Residuum22/EDFAController/README.md

# EDFAController
This project was created for my MSc thesis This project mixes the mm_edfa_boards and mm_edfa_web projects.
