Residuum22/EDFAController/EDFABoards/Simulation/ESDProtection/ESDProtection.asc

A1: varistor
C1: cap; 100n
D1: TVSdiode; SMCJ33A
L1: ind; 220m
R1: res; 100
V1: voltage; PULSE(0 500 1 20m 20m 1 3)
V2: voltage; 30
Named nets: 0
.tran 5
