Residuum22/EDFAController/EDFABoards/Simulation/LaserControllerCircuit/LaserControllerCircuit.asc

D1: LED; LXHL-BW02
D2: LED; LXHL-BW02
M1: nmos; RTL035N03
M3: nmos; RTL035N03
R1: res; 100
R2: res; 10k
R3: res; 0.1
R4: res; 680
R5: res; 0.42
R6: res; 100
R7: res; 0.1
R8: res; 10k
R9: res; 300
R10: res; 0.076
R11: res; 10k
R13: res; 10k
U1: OP07
U2: OP07
V2: voltage; 5
V5: voltage; PWL file=C:\Users\mihal\development\PWLGenerator\demofile2.txt
Named nets: 5V, 0, SIGNAL
.tran 30
980 nm Pump Laser
1480 nm Pump Laser
