Residuum22/EDFAController/EDFABoards/Simulation/MonitorDiode/monitordiode.asc

C1: cap; 10µ
D1: diode
I1: current; SINE(200e-6 200e-6 1)
R1: res; 10k
R2: res; 10k
R3: res; 10k
U1: OP07
V1: voltage; 5
Named nets: 0, 5V
.tran 1
