Residuum22/EDFAController/EDFABoards/Simulation/ReserveAndOverVoltageProtection/ReserveOverVoltageProtection.asc

D1: zener; UMZ5_1N
D2: zener; MMBZ6V8ALY
M1: pmos; Si7137DP
M2: pmos; Si7137DP
M3: pmos; Si7137DP
R1: res; 10k
R2: res; 10k
R3: res; 10k
R4: res; 100
V1: voltage; PWL(0 0 1 5 2 5 3 6 4 6 5 0 6 0 7 -5 8 -5)
Named nets: 0
.tran 8s
