Residuum22/EDFAController/EDFABoards/Hardware/cable_board_kicad_prj/cable_board_kicad_prj.kicad_pcb

## KiCad design EDFABoards/Hardware/cable_board_kicad_prj/cable_board_kicad_prj.kicad_pcb (2024-10-13)

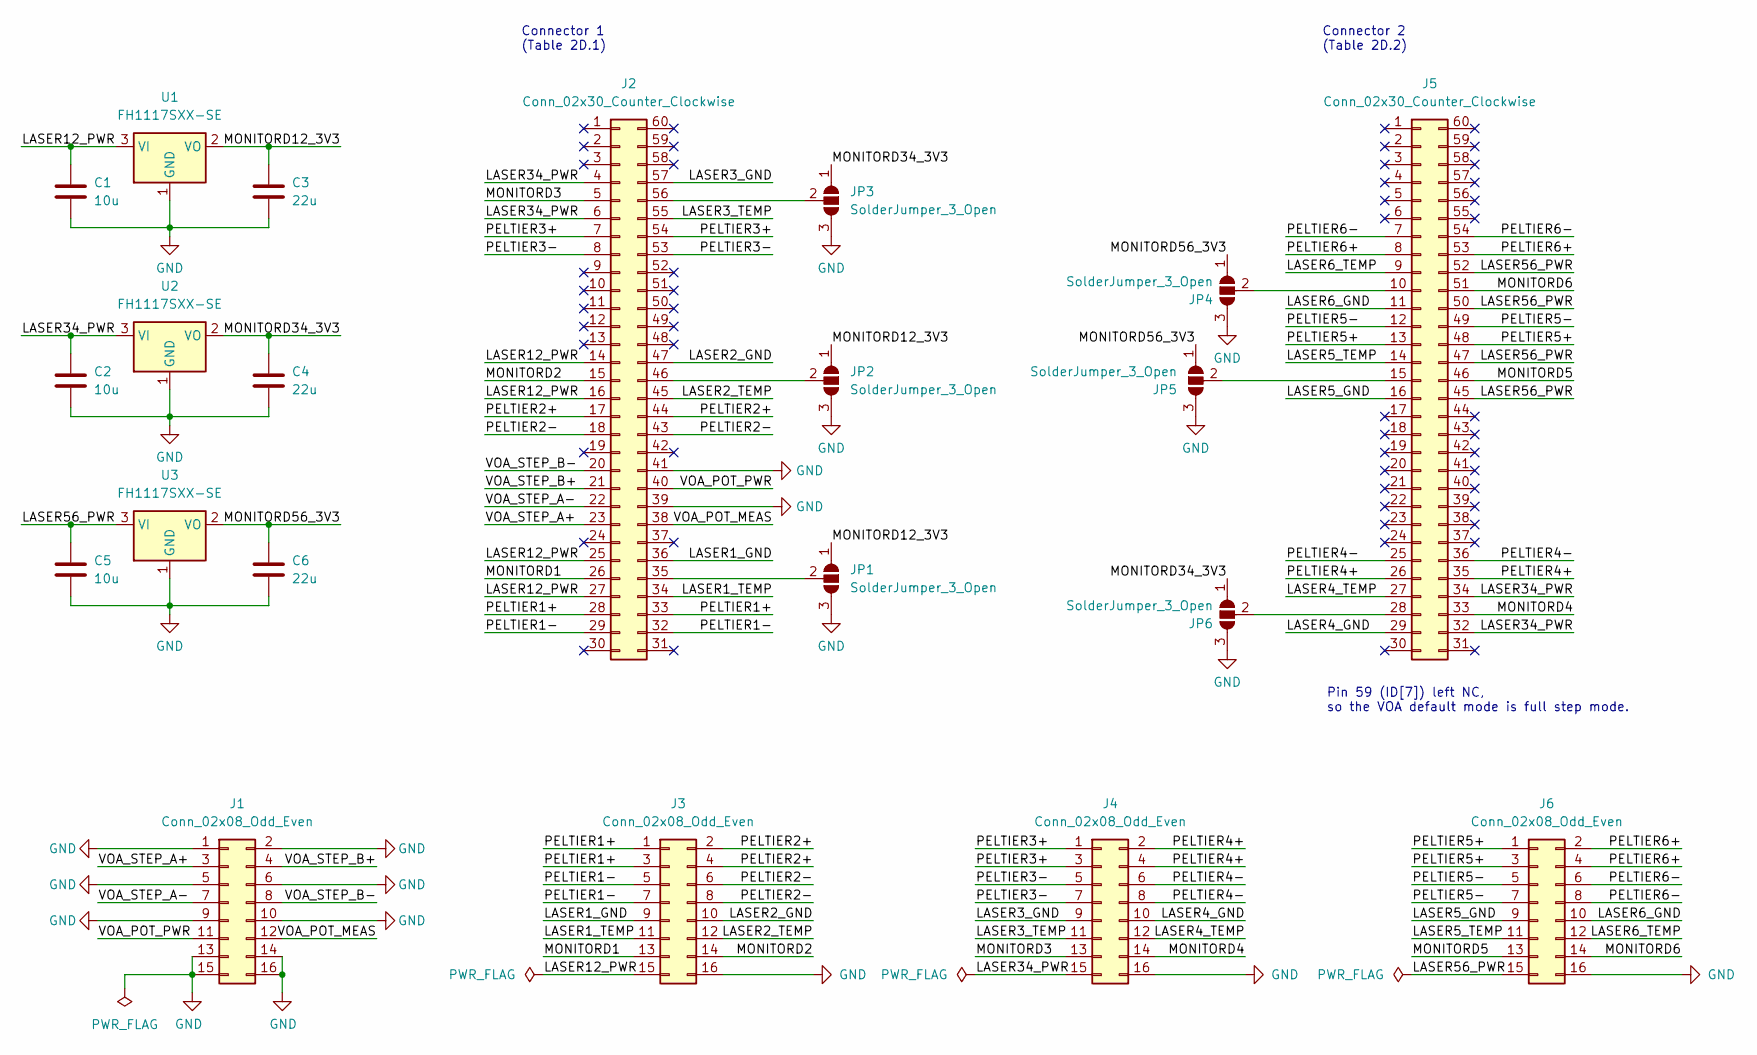
[picture p2: schematic cable_board_kicad_prj.kicad_sch, Cable board]

Parts:
C1, C2, C5: 10u; C_0805_2012Metric_Pad1.18x1.45mm_HandSolder
C3, C4, C6: 22u; C_0805_2012Metric_Pad1.18x1.45mm_HandSolder
J1, J3, J4, J6: Conn_02x08_Odd_Even; IDC-Header_2x08_P2.54mm_Latch_Vertical
J2, J5: Conn_02x30_Counter_Clockwise; IDC-Header_2x30_P2.54mm_Latch_Vertical
JP1, JP2, JP3, JP4, JP5, JP6: SolderJumper_3_Open; SolderJumper-3_P1.3mm_Open_RoundedPad1.0x1.5mm
U1, U2, U3: FH1117SXX-SE; SOT-223-3_TabPin2

Connections:
/LASER1_GND: J2.36, J3.9
/LASER1_TEMP: J2.34, J3.11
/LASER2_GND: J2.47, J3.10
/LASER2_TEMP: J2.45, J3.12
/LASER3_GND: J2.57, J4.9
/LASER3_TEMP: J2.55, J4.11
/LASER4_GND: J4.10, J5.29
/LASER4_TEMP: J4.12, J5.27
/LASER5_GND: J5.16, J6.9
/LASER5_TEMP: J5.14, J6.11
/LASER6_GND: J5.11, J6.10
/LASER6_TEMP: J5.9, J6.12
/LASER12_PWR: C1.1, J2.14, J2.16, J2.25, J2.27, J3.15, U1.3 (VI)
/LASER34_PWR: C2.1, J2.4, J2.6, J4.15, J5.32, J5.34, U2.3 (VI)
/LASER56_PWR: C5.1, J5.45, J5.47, J5.50, J5.52, J6.15, U3.3 (VI)
/MONITORD1: J2.26, J3.13
/MONITORD2: J2.15, J3.14
/MONITORD3: J2.5, J4.13
/MONITORD4: J4.14, J5.33
/MONITORD5: J5.46, J6.13
/MONITORD6: J5.51, J6.14
/MONITORD12_3V3: C3.1, JP1.1 (A), JP2.1 (A), U1.2 (VO)
/MONITORD34_3V3: C4.1, JP3.1 (A), JP6.1 (A), U2.2 (VO)
/MONITORD56_3V3: C6.1, JP4.1 (A), JP5.1 (A), U3.2 (VO)
/PELTIER1+: J2.28, J2.33, J3.1, J3.3
/PELTIER1-: J2.29, J2.32, J3.5, J3.7
/PELTIER2+: J2.17, J2.44, J3.2, J3.4
/PELTIER2-: J2.18, J2.43, J3.6, J3.8
/PELTIER3+: J2.7, J2.54, J4.1, J4.3
/PELTIER3-: J2.8, J2.53, J4.5, J4.7
/PELTIER4+: J4.2, J4.4, J5.26, J5.35
/PELTIER4-: J4.6, J4.8, J5.25, J5.36
/PELTIER5+: J5.13, J5.48, J6.1, J6.3
/PELTIER5-: J5.12, J5.49, J6.5, J6.7
/PELTIER6+: J5.8, J5.53, J6.2, J6.4
/PELTIER6-: J5.7, J5.54, J6.6, J6.8
/VOA_POT_MEAS: J1.12, J2.38
/VOA_POT_PWR: J1.11, J2.40
/VOA_STEP_A+: J1.3, J2.23
/VOA_STEP_A-: J1.7, J2.22
/VOA_STEP_B+: J1.4, J2.21
/VOA_STEP_B-: J1.8, J2.20
GND: C1.2, C2.2, C3.2, C4.2, C5.2, C6.2, J1.1, J1.2, J1.5, J1.6, J1.9, J1.10, J1.13, J1.14, J1.15, J1.16, J2.39, J2.41, J3.16, J4.16, J6.16, JP1.3 (B), JP2.3 (B), JP3.3 (B), JP4.3 (B), JP5.3 (B), JP6.3 (B), U1.1 (GND), U2.1 (GND), U3.1 (GND)
unnamed: J2.35, JP1.2 (C)
unnamed: J2.46, JP2.2 (C)
unnamed: J2.56, JP3.2 (C)
unnamed: J5.10, JP4.2 (C)
unnamed: J5.15, JP5.2 (C)
unnamed: J5.28, JP6.2 (C)

Notes on the sheet:
Connector 1 (Table 2D.1)
Connector 2 (Table 2D.2)
Pin 59 (ID[7]) left NC, so the VOA default mode is full step mode.

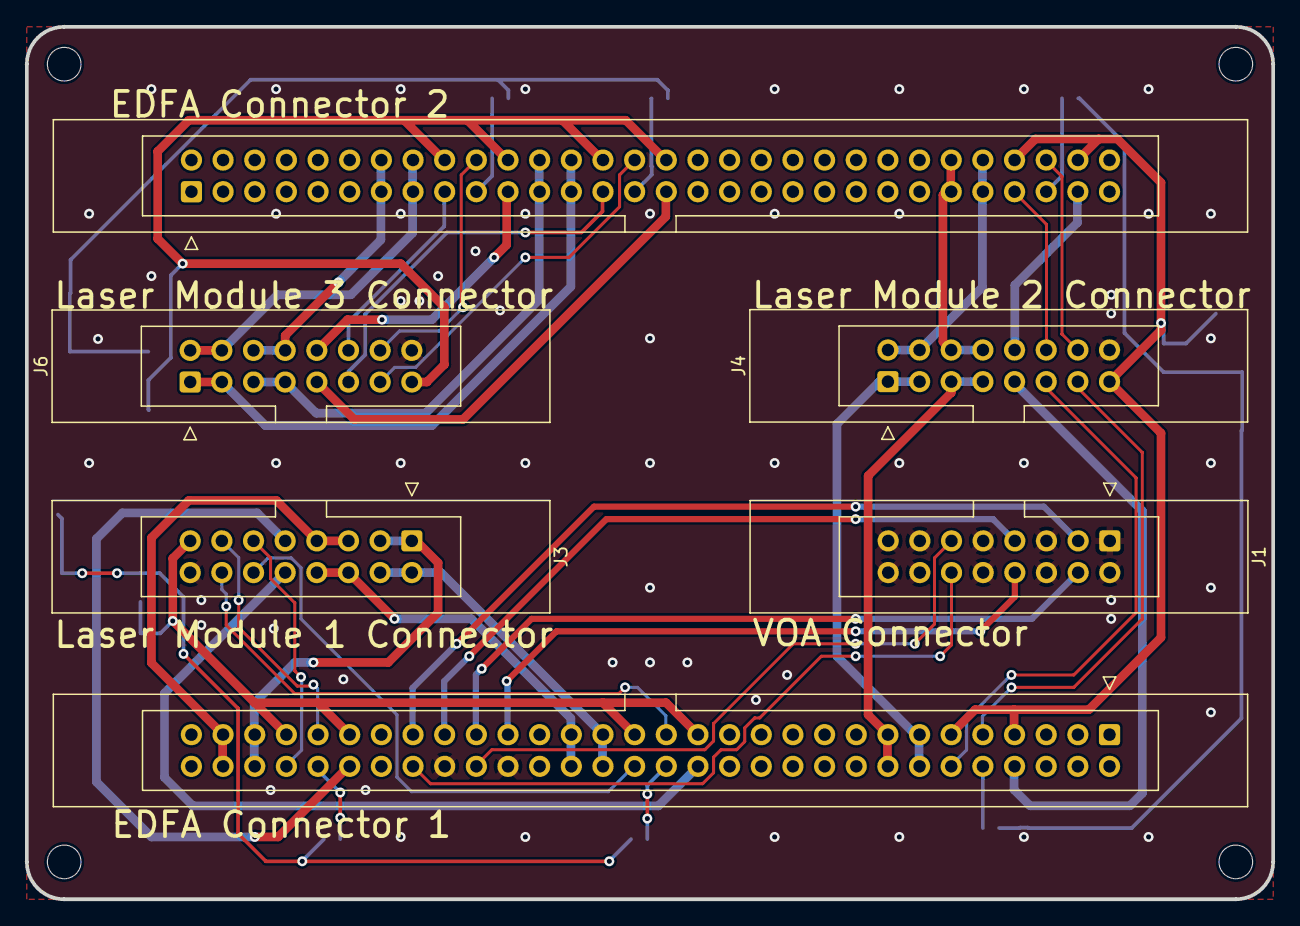
[picture p3: board cable_board_kicad_prj.kicad_pcb from above]

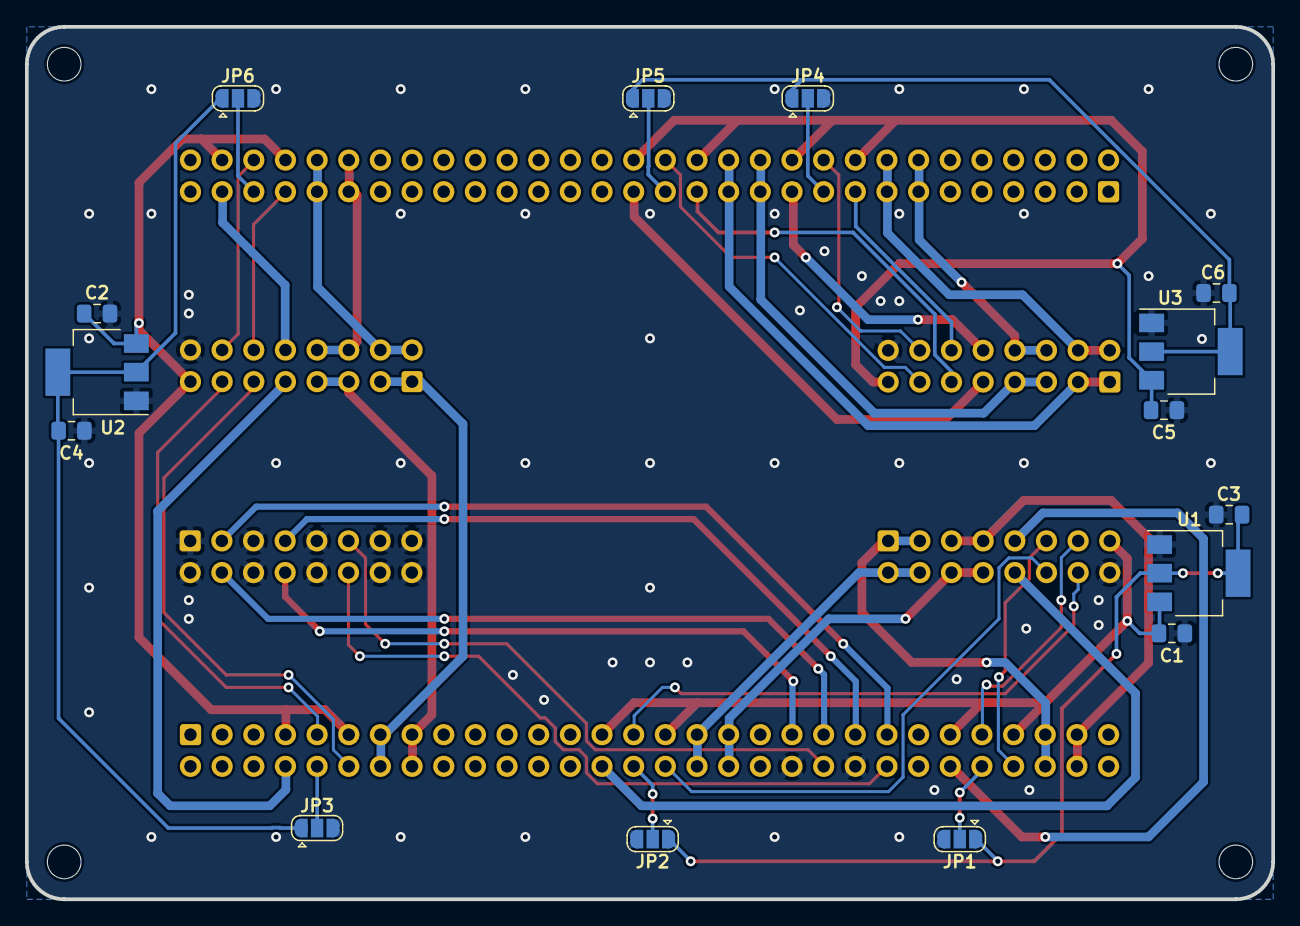
[picture p4: board cable_board_kicad_prj.kicad_pcb from below]

Board: 2 copper layers, 100.0 x 70.0 mm, 21 parts (15 on the bottom side), 49 nets.
