Residuum22/EDFAController/EDFABoards/Hardware/laser_module_kicad_prj/laser_module_kicad_prj.kicad_pcb

## KiCad design EDFABoards/Hardware/laser_module_kicad_prj/laser_module_kicad_prj.kicad_pcb (2024-10-13)

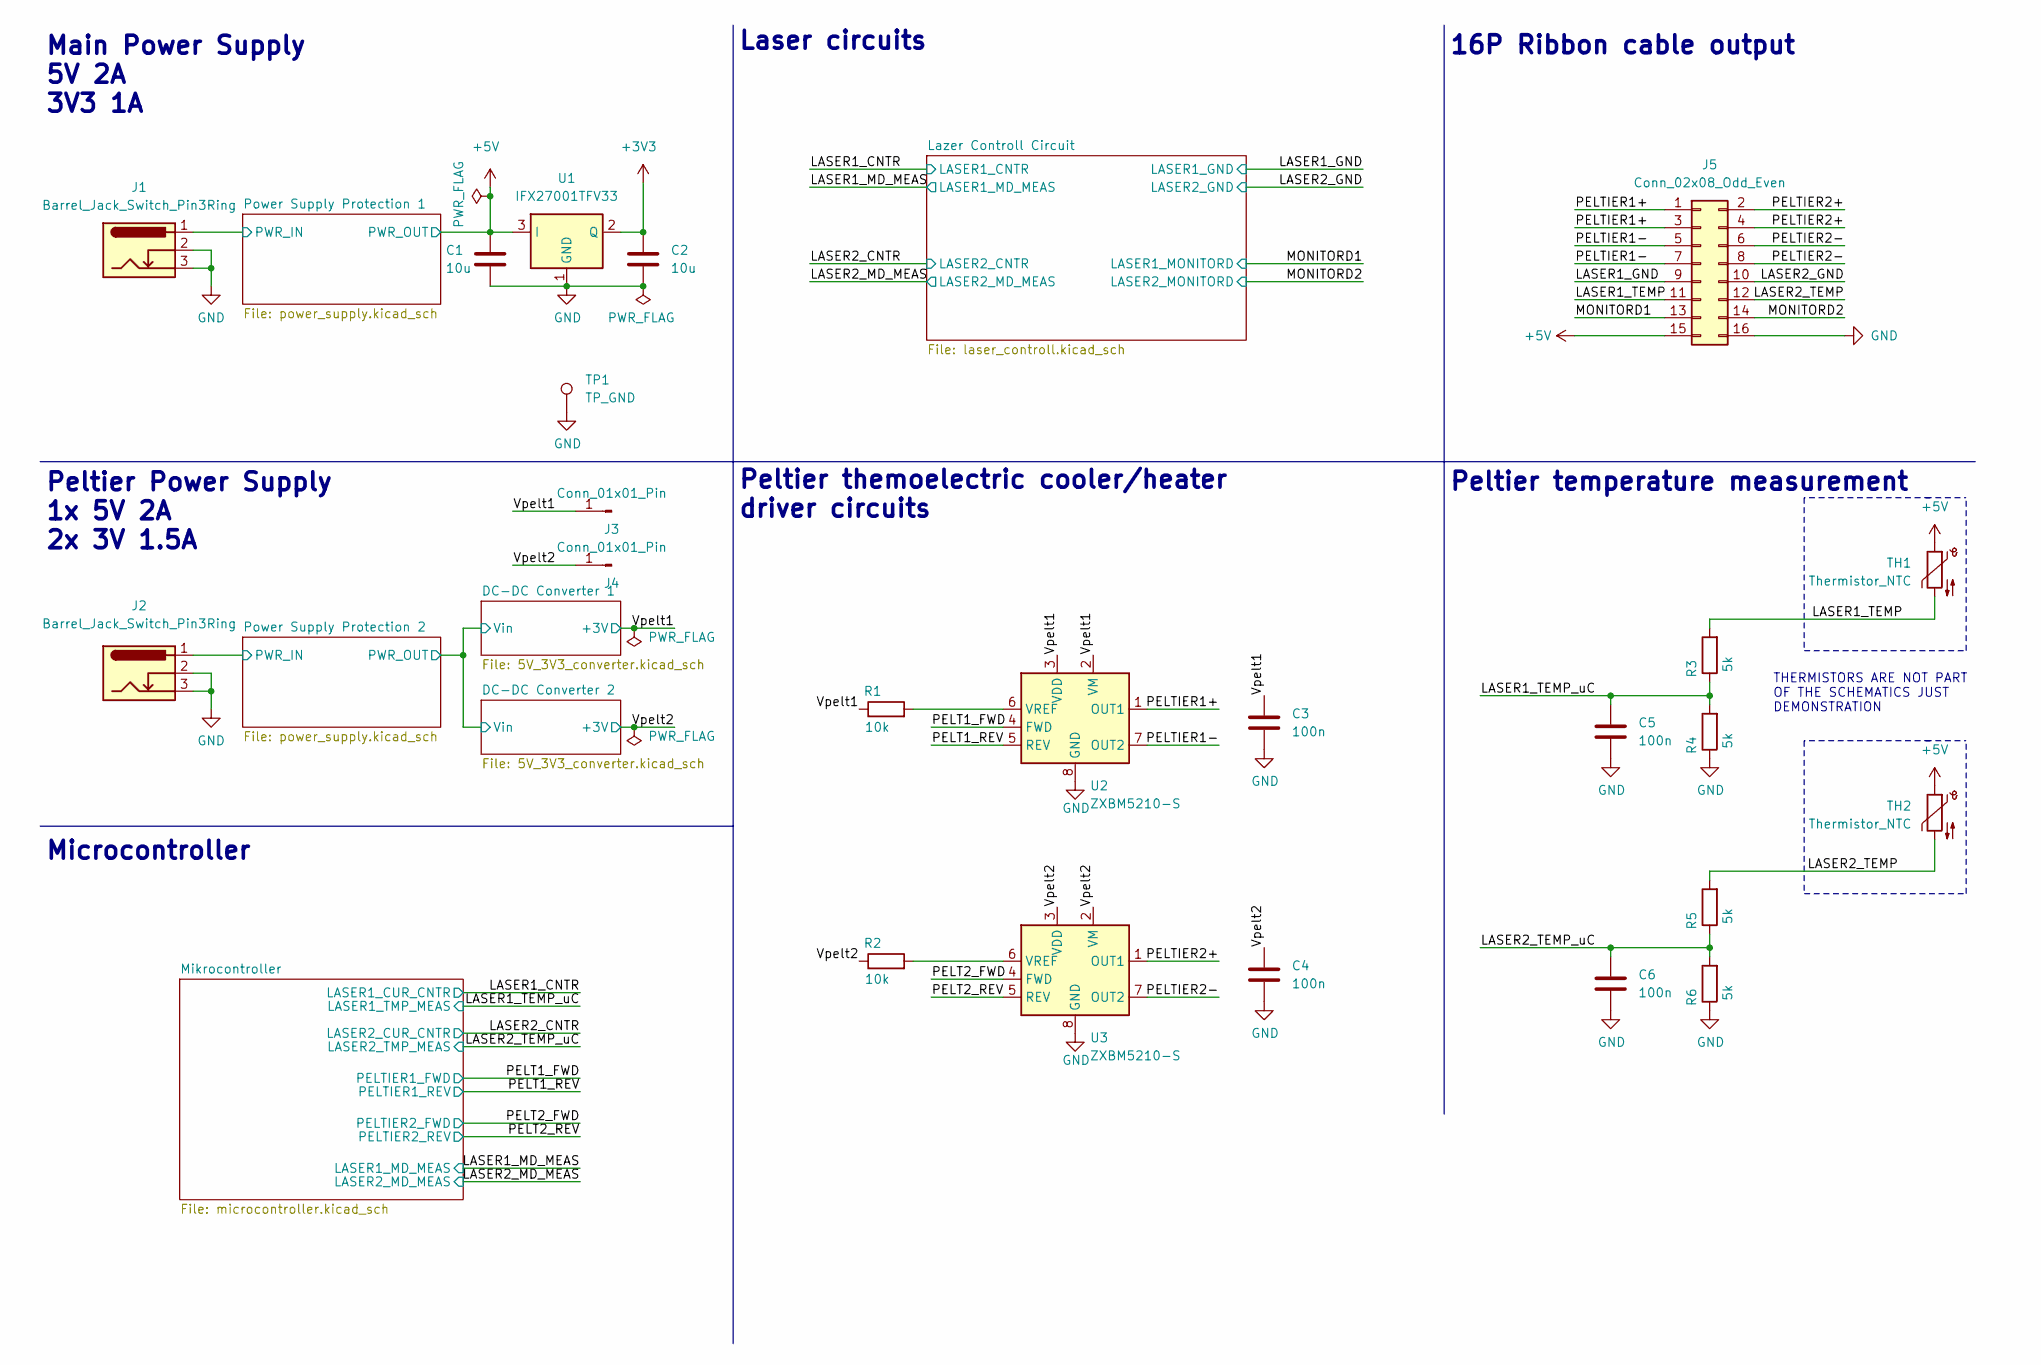
[picture p5: schematic laser_module_kicad_prj.kicad_sch, Laser controller board (Project Sheet)]

Parts:
C1, C2: 10u; C_0805_2012Metric_Pad1.18x1.45mm_HandSolder
C3, C4, C5, C6: 100n; C_0805_2012Metric_Pad1.18x1.45mm_HandSolder
J1, J2: Barrel_Jack_Switch_Pin3Ring; BarrelJack_Horizontal
J3, J4: Conn_01x01_Pin; PinHeader_1x01_P2.54mm_Vertical
J5: Conn_02x08_Odd_Even; IDC-Header_2x08_P2.54mm_Latch_Vertical
R1, R2: 10k; R_0805_2012Metric_Pad1.20x1.40mm_HandSolder
R3, R4, R5, R6: 5k; R_0805_2012Metric_Pad1.20x1.40mm_HandSolder
TH1, TH2: Thermistor_NTC
TP1: TP_GND; PinHeader_1x01_P2.54mm_Vertical
U1: IFX27001TFV33; TO-252-3_TabPin2
U2, U3: ZXBM5210-S; SOIC-8_3.9x4.9mm_P1.27mm; Mouser 621-ZXBM5210-S-13

Connections:
+3V3: C2.1, U1.2 (Q); also elsewhere on the board
+5V: C1.1, J5.15, TH1.1, TH2.1, U1.3 (I); also elsewhere on the board
/LASER1_GND: J5.9; also elsewhere on the board
/LASER1_TEMP: J5.11, R3.2, TH1.2
/LASER1_TEMP_uC: C5.1, R3.1, R4.2; also elsewhere on the board
/LASER2_GND: J5.10; also elsewhere on the board
/LASER2_TEMP: J5.12, R5.2, TH2.2
/LASER2_TEMP_uC: C6.1, R5.1, R6.2; also elsewhere on the board
/MONITORD1: J5.13; also elsewhere on the board
/MONITORD2: J5.14; also elsewhere on the board
/PELT1_FWD: U2.4 (FWD); also elsewhere on the board
/PELT1_REV: U2.5 (REV); also elsewhere on the board
/PELT2_FWD: U3.4 (FWD); also elsewhere on the board
/PELT2_REV: U3.5 (REV); also elsewhere on the board
/PELTIER1+: J5.1, J5.3, U2.1 (OUT1)
/PELTIER1-: J5.5, J5.7, U2.7 (OUT2)
/PELTIER2+: J5.2, J5.4, U3.1 (OUT1)
/PELTIER2-: J5.6, J5.8, U3.7 (OUT2)
/Power Supply Protection 1/PWR_IN: J1.1; also elsewhere on the board
/Power Supply Protection 2/PWR_IN: J2.1; also elsewhere on the board
/Vpelt1: C3.1, J3.1, R1.1, U2.2 (VM), U2.3 (VDD); also elsewhere on the board
/Vpelt2: C4.1, J4.1, R2.1, U3.2 (VM), U3.3 (VDD); also elsewhere on the board
GND: C1.2, C2.2, C3.2, C4.2, C5.2, C6.2, J1.2, J1.3, J2.2, J2.3, J5.16, R4.1, R6.1, TP1.1, U1.1 (GND), U2.8 (GND), U3.8 (GND); also elsewhere on the board
unnamed: R1.2, U2.6 (VREF)
unnamed: R2.2, U3.6 (VREF)

Notes on the sheet:
Peltier themoelectric cooler/heater driver circuits
16P Ribbon cable output
Microcontroller
Peltier Power Supply 1x 5V 2A 2x 3V 1.5A
Main Power Supply 5V 2A 3V3 1A
THERMISTORS ARE NOT PART OF THE SCHEMATICS JUST DEMONSTRATION
Peltier temperature measurement
Laser circuits

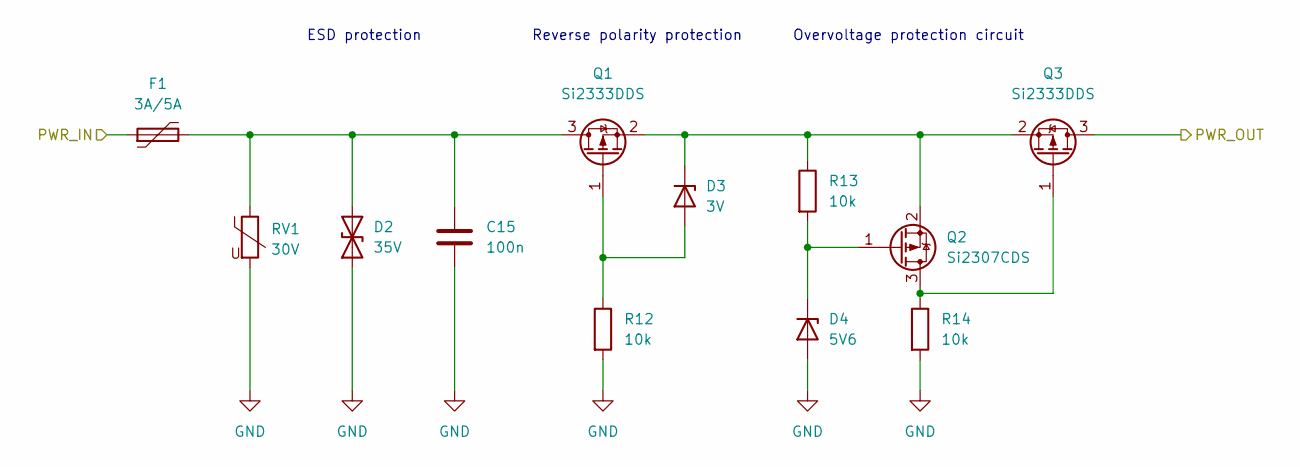
[picture p6: schematic power_supply.kicad_sch, Laser controller board (Project Sheet)]

Parts:
C15: 100n; C_0805_2012Metric_Pad1.18x1.45mm_HandSolder
D2: 35V; D_SMB
D3: 3V; D_MiniMELF_Handsoldering
D4: 5V6; D_MiniMELF_Handsoldering
F1: 3A/5A; Fuse_2920_7451Metric_Pad2.10x5.45mm_HandSolder; Mouser 652-MF-LSMF500/16X-2
Q1, Q3: Si2333DDS; SOT-23_Handsoldering; Mouser 78-SI2333DDS-T1-BE3
Q2: Si2307CDS; SOT-23_Handsoldering
R12, R13, R14: 10k; R_0805_2012Metric_Pad1.20x1.40mm_HandSolder
RV1: 30V; R_1206_3216Metric_Pad1.30x1.75mm_HandSolder

Connections:
+5V: Q3.3 (D); also elsewhere on the board
/Power Supply Protection 1/PWR_IN: F1.1; also elsewhere on the board
GND: C15.2, D2.1 (A1), D4.2 (A), R12.2, R14.2, RV1.2; also elsewhere on the board
unnamed: C15.1, D2.2 (A2), F1.2, Q1.3 (D), RV1.1
unnamed: D3.2 (A), Q1.1 (G), R12.1
unnamed: D3.1 (K), Q1.2 (S), Q2.2 (S), Q3.2 (S), R13.1
unnamed: D4.1 (K), Q2.1 (G), R13.2
unnamed: Q2.3 (D), Q3.1 (G), R14.1

Parts of its further copies:
C20: 100n; C_0805_2012Metric_Pad1.18x1.45mm_HandSolder
D5: 35V; D_SMB
D6: 3V; D_MiniMELF_Handsoldering
D7: 5V6; D_MiniMELF_Handsoldering
F4: 3A/5A; Fuse_2920_7451Metric_Pad2.10x5.45mm_HandSolder; Mouser 652-MF-LSMF500/16X-2
Q6, Q8: Si2333DDS; SOT-23_Handsoldering; Mouser 78-SI2333DDS-T1-BE3
Q7: Si2307CDS; SOT-23_Handsoldering
R33, R34, R35: 10k; R_0805_2012Metric_Pad1.20x1.40mm_HandSolder
RV6: 30V; R_1206_3216Metric_Pad1.30x1.75mm_HandSolder

Connections of its further copies:
/DC-DC Converter 1/Vin: Q8.3 (D); also elsewhere on the board
/Power Supply Protection 2/PWR_IN: F4.1; also elsewhere on the board
GND: C20.2, D5.1 (A1), D7.2 (A), R33.2, R35.2, RV6.2; also elsewhere on the board
unnamed: C20.1, D5.2 (A2), F4.2, Q6.3 (D), RV6.1
unnamed: D6.2 (A), Q6.1 (G), R33.1
unnamed: D6.1 (K), Q6.2 (S), Q7.2 (S), Q8.2 (S), R34.1
unnamed: D7.1 (K), Q7.1 (G), R34.2
unnamed: Q7.3 (D), Q8.1 (G), R35.1

Notes on the sheet:
Reverse polarity protection
ESD protection
Overvoltage protection circuit

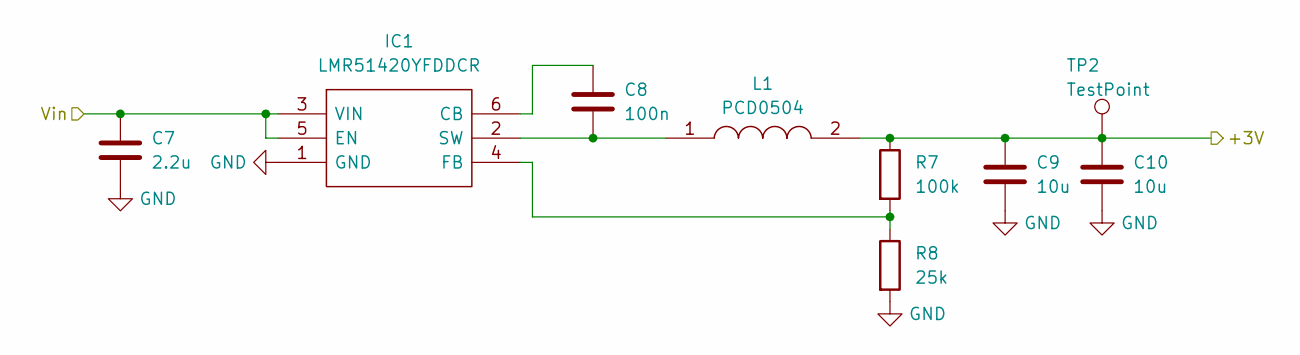
[picture p7: schematic 5V_3V3_converter.kicad_sch, Laser controller board (Project Sheet)]

Parts:
C7: 2.2u; C_0805_2012Metric_Pad1.18x1.45mm_HandSolder
C8: 100n; C_0805_2012Metric_Pad1.18x1.45mm_HandSolder
C9, C10: 10u; C_0805_2012Metric_Pad1.18x1.45mm_HandSolder
IC1: LMR51420YFDDCR; SOT95P280X110-6N; Mouser Part Number 595-LMR51420YFDDCR
L1: PCD0504; Manufacturer_Part_Number PCD0504
R7: 100k; R_0805_2012Metric_Pad1.20x1.40mm_HandSolder
R8: 25k; R_0805_2012Metric_Pad1.20x1.40mm_HandSolder
TP2: TestPoint; TestPoint_Pad_D2.5mm

Connections:
/DC-DC Converter 1/Vin: C7.1, IC1.3 (VIN), IC1.5 (EN); also elsewhere on the board
/Vpelt1: C9.1, C10.1, L1.2, R7.1, TP2.1; also elsewhere on the board
GND: C7.2, C9.2, C10.2, IC1.1 (GND), R8.2; also elsewhere on the board
unnamed: C8.1, IC1.6 (CB)
unnamed: IC1.4 (FB), R7.2, R8.1
unnamed: C8.2, IC1.2 (SW), L1.1

Parts of its further copies:
C21: 2.2u; C_0805_2012Metric_Pad1.18x1.45mm_HandSolder
C22: 100n; C_0805_2012Metric_Pad1.18x1.45mm_HandSolder
C23, C24: 10u; C_0805_2012Metric_Pad1.18x1.45mm_HandSolder
IC3: LMR51420YFDDCR; SOT95P280X110-6N; Mouser Part Number 595-LMR51420YFDDCR
L2: PCD0504; Manufacturer_Part_Number PCD0504
R36: 100k; R_0805_2012Metric_Pad1.20x1.40mm_HandSolder
R37: 25k; R_0805_2012Metric_Pad1.20x1.40mm_HandSolder
TP5: TestPoint; TestPoint_Pad_D2.5mm

Connections of its further copies:
/DC-DC Converter 1/Vin: C21.1, IC3.3 (VIN), IC3.5 (EN); also elsewhere on the board
/Vpelt2: C23.1, C24.1, L2.2, R36.1, TP5.1; also elsewhere on the board
GND: C21.2, C23.2, C24.2, IC3.1 (GND), R37.2; also elsewhere on the board
unnamed: C22.1, IC3.6 (CB)
unnamed: IC3.4 (FB), R36.2, R37.1
unnamed: C22.2, IC3.2 (SW), L2.1

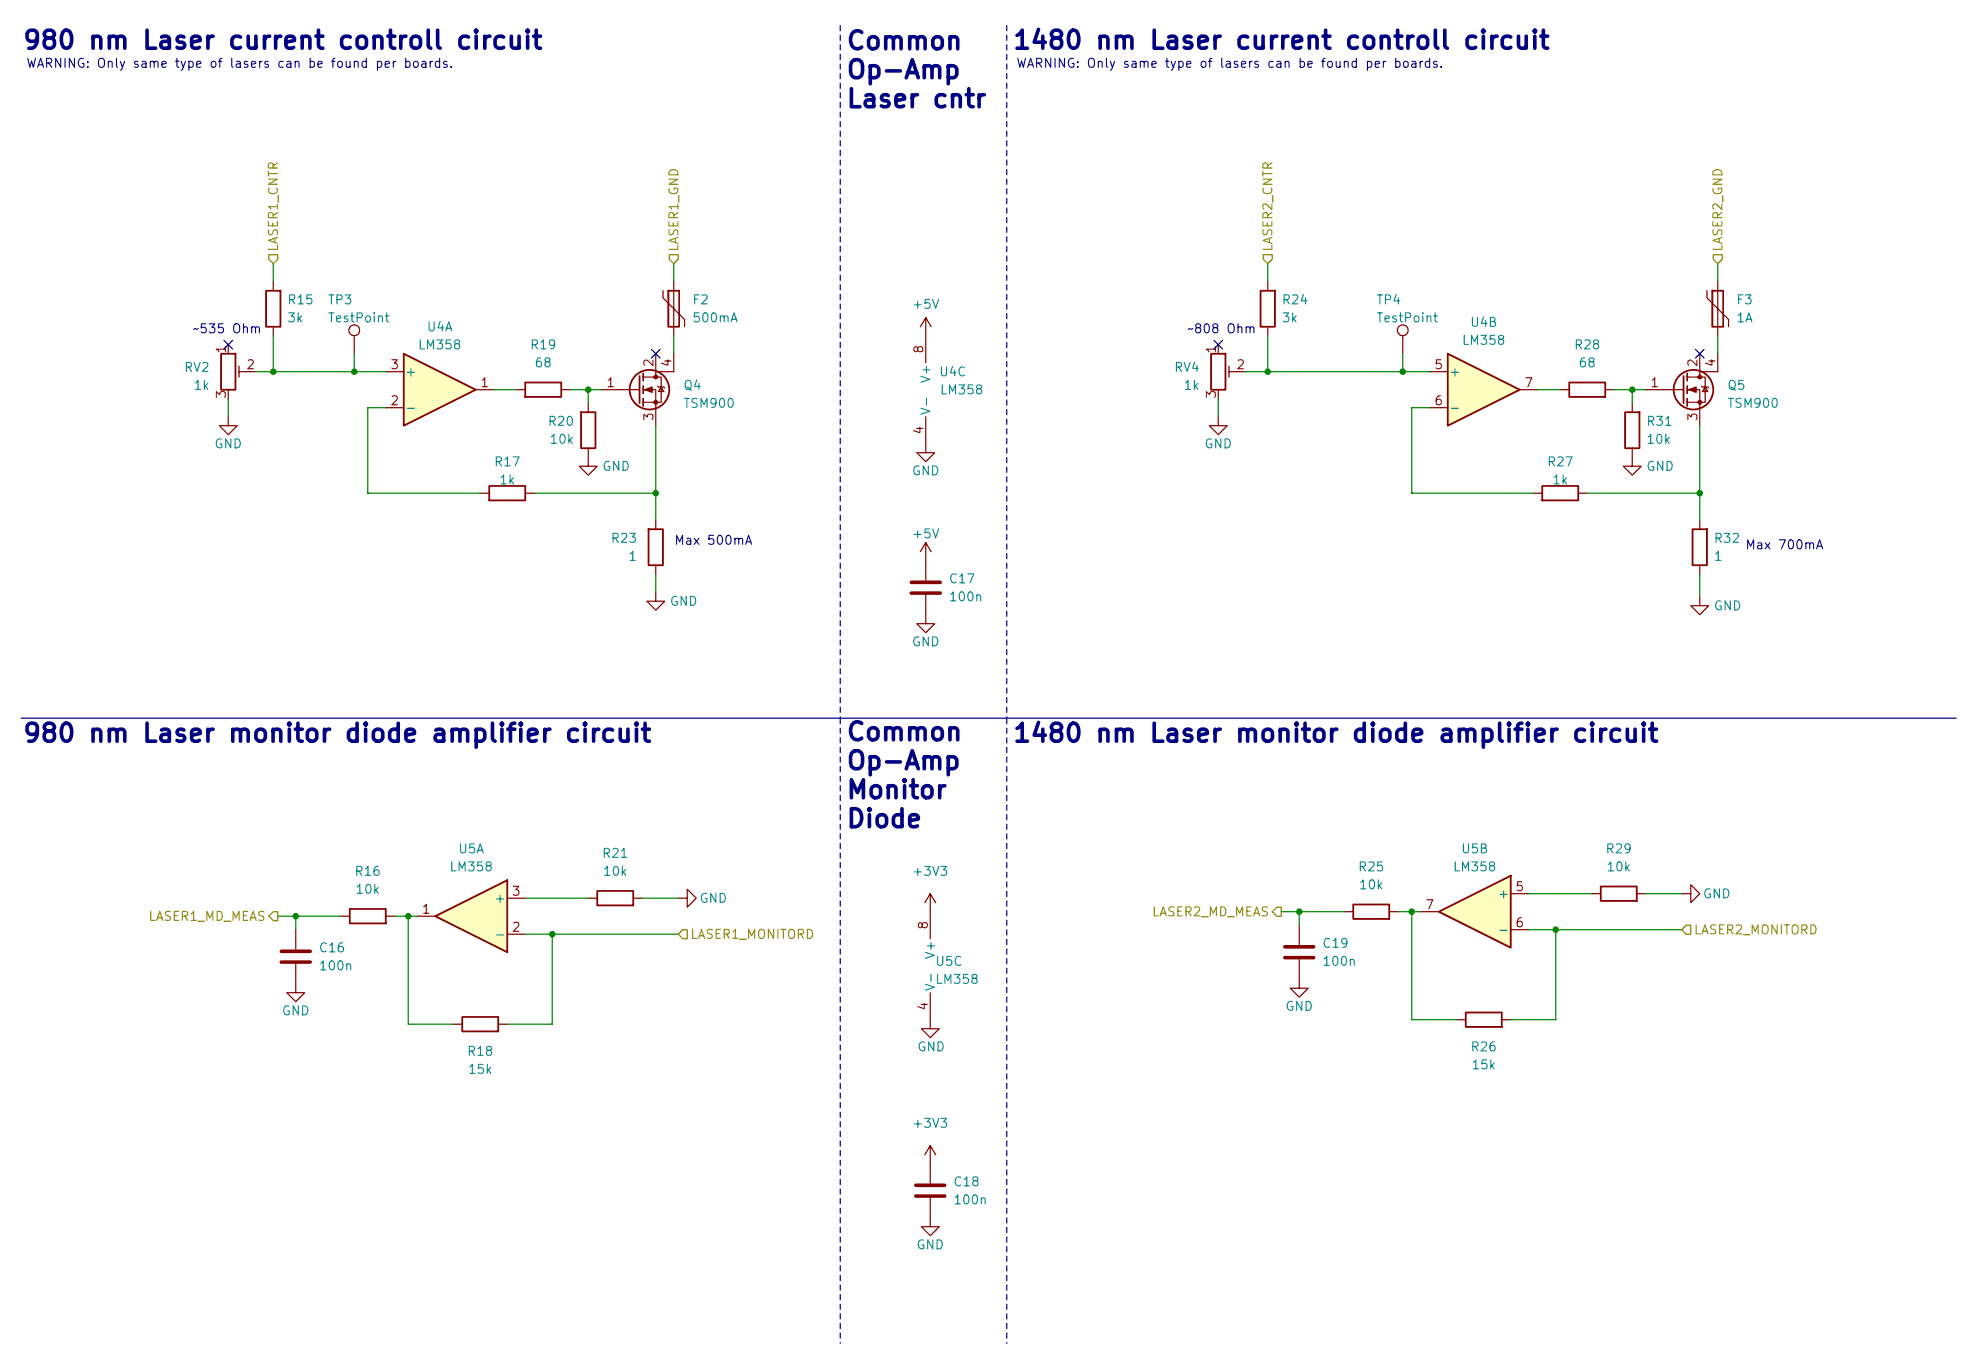
[picture p8: schematic laser_controll.kicad_sch, Laser controller board (Project Sheet)]

Parts:
C16, C17, C18, C19: 100n; C_0805_2012Metric_Pad1.18x1.45mm_HandSolder
F2: 500mA; Fuse_2512_6332Metric_Pad1.52x3.35mm_HandSolder
F3: 1A; Fuse_2512_6332Metric_Pad1.52x3.35mm_HandSolder
Q4, Q5: TSM900; SOT-223
R15, R24: 3k; R_0805_2012Metric_Pad1.20x1.40mm_HandSolder
R16, R20, R21, R25, R29, R31: 10k; R_0805_2012Metric_Pad1.20x1.40mm_HandSolder
R17, R27: 1k; R_0805_2012Metric_Pad1.20x1.40mm_HandSolder
R18, R26: 15k; R_0805_2012Metric_Pad1.20x1.40mm_HandSolder
R19, R28: 68; R_0805_2012Metric_Pad1.20x1.40mm_HandSolder
R23, R32: 1; R_2512_6332Metric_Pad1.40x3.35mm_HandSolder
RV2, RV4: 1k; Potentiometer_Bourns_3296X_Horizontal
TP3, TP4: TestPoint; TestPoint_Pad_D2.5mm
U4, U5: LM358; SOIC-8_3.9x4.9mm_P1.27mm

Connections:
+3V3: C18.1, U5.8 (V+); also elsewhere on the board
+5V: C17.1, U4.8 (V+); also elsewhere on the board
/LASER1_CNTR: R15.2; also elsewhere on the board
/LASER1_GND: F2.1; also elsewhere on the board
/LASER1_MD_MEAS: C16.1, R16.1; also elsewhere on the board
/LASER2_CNTR: R24.2; also elsewhere on the board
/LASER2_GND: F3.1; also elsewhere on the board
/LASER2_MD_MEAS: C19.1, R25.1; also elsewhere on the board
/MONITORD1: R18.2, U5.2 (-); also elsewhere on the board
/MONITORD2: R26.2, U5.6 (-); also elsewhere on the board
GND: C16.2, C17.2, C18.2, C19.2, R20.1, R21.2, R23.1, R29.2, R31.1, R32.1, RV2.3, RV4.3, U4.4 (V-), U5.4 (V-); also elsewhere on the board
unnamed: F2.2, Q4.4 (D)
unnamed: F3.2, Q5.4 (D)
unnamed: Q4.1 (G), R19.1, R20.2
unnamed: Q4.3 (S), R17.1, R23.2
unnamed: Q5.1 (G), R28.2, R31.2
unnamed: Q5.3 (S), R27.1, R32.2
unnamed: R16.2, R18.1, U5.1
unnamed: R19.2, U4.1
unnamed: R25.2, R26.1, U5.7
unnamed: R28.1, U4.7
unnamed: R15.1, RV2.2, TP3.1, U4.3 (+)
unnamed: R17.2, U4.2 (-)
unnamed: R24.1, RV4.2, TP4.1, U4.5 (+)
unnamed: R27.2, U4.6 (-)
unnamed: R21.1, U5.3 (+)
unnamed: R29.1, U5.5 (+)

Notes on the sheet:
Max 700mA
980 nm Laser monitor diode amplifier circuit
~535 Ohm
1480 nm Laser current controll circuit
980 nm Laser current controll circuit
1480 nm Laser monitor diode amplifier circuit
~808 Ohm
Common Op-Amp Monitor Diode
WARNING: Only same type of lasers can be found per boards.
Max 500mA
Common Op-Amp Laser cntr

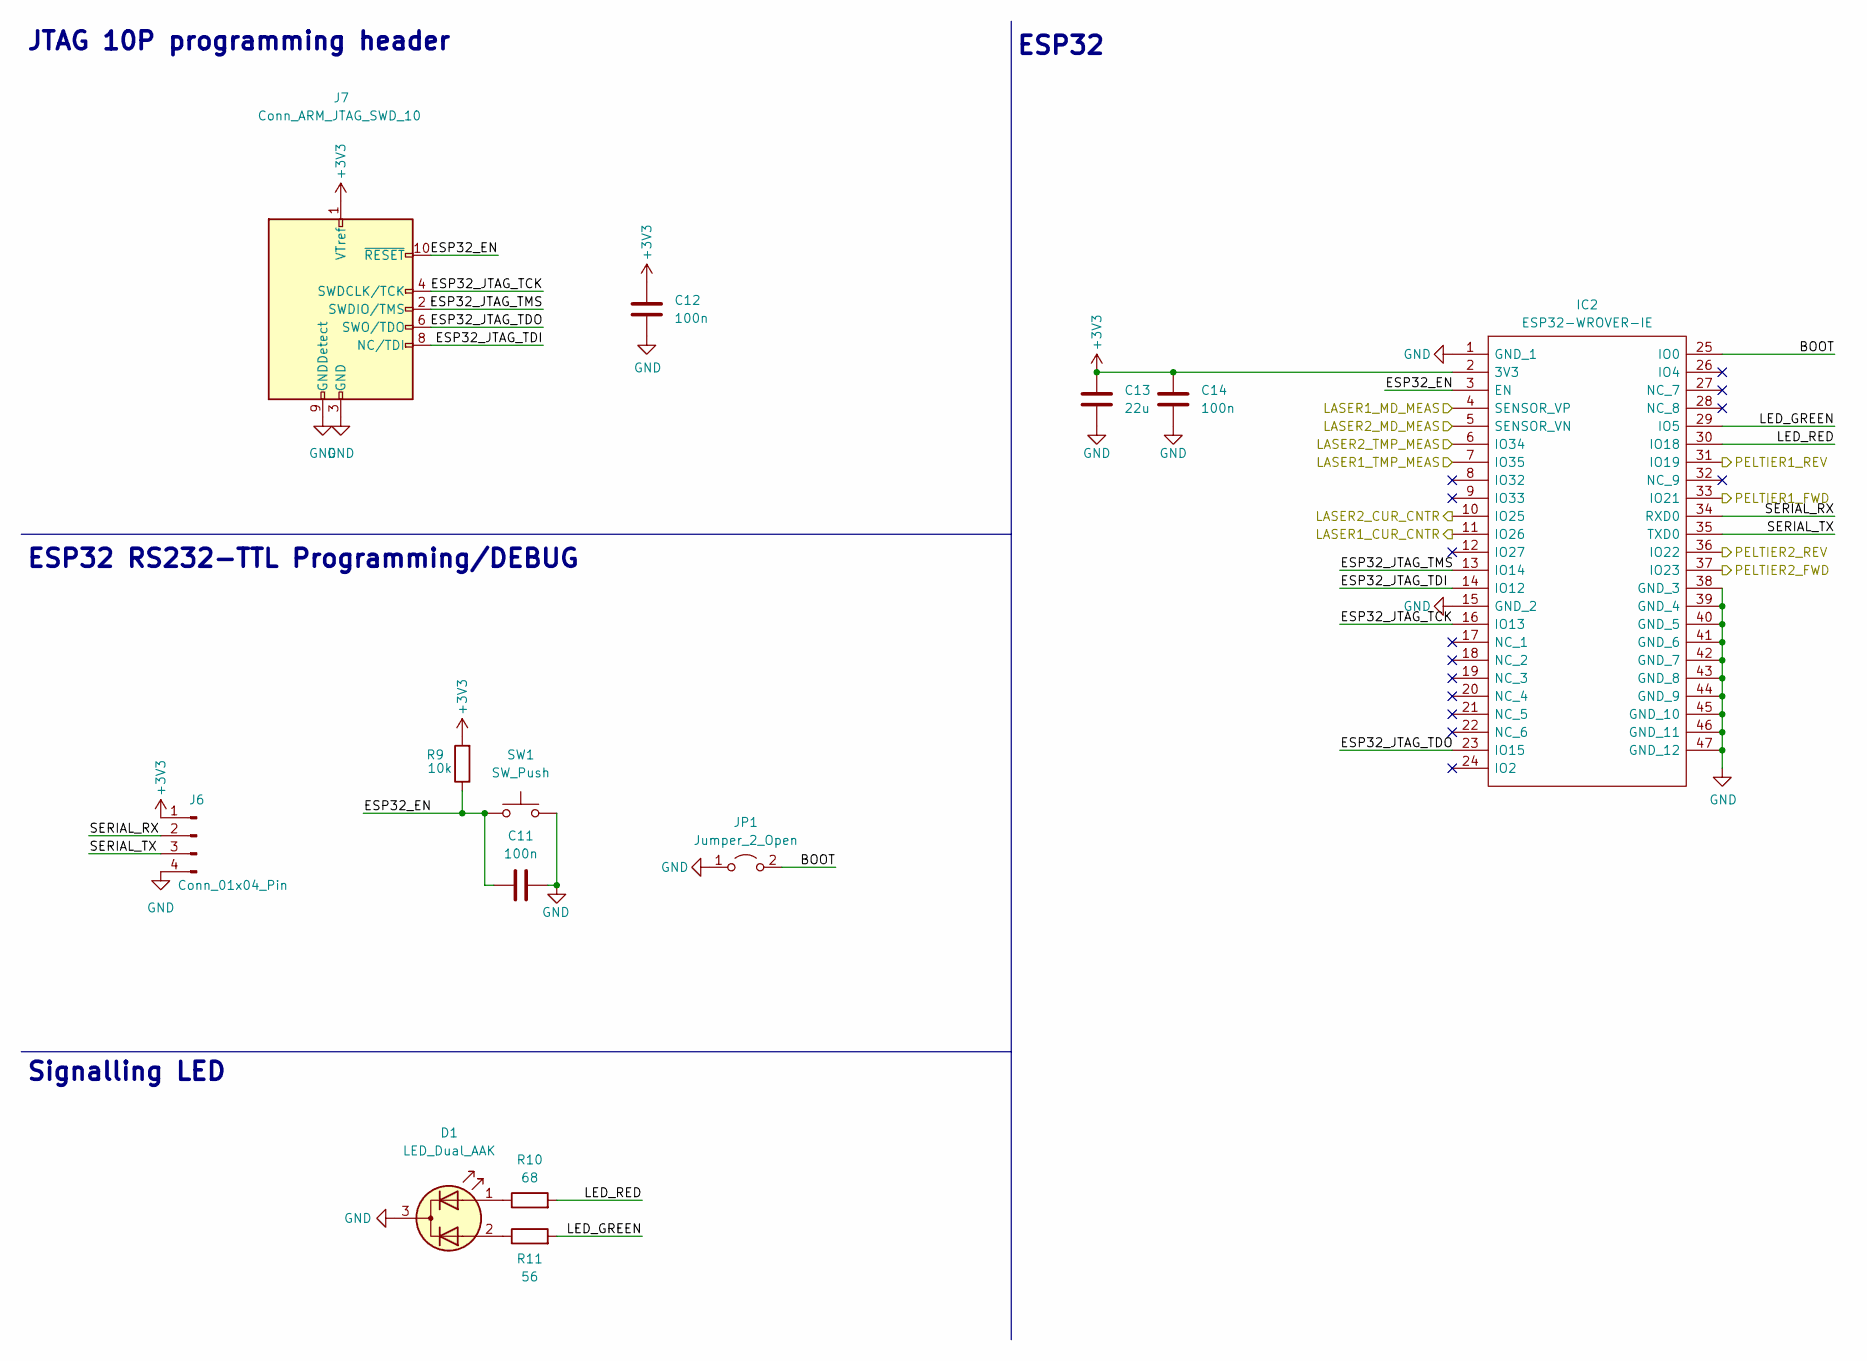
[picture p9: schematic microcontroller.kicad_sch, Laser controller board (Project Sheet)]

Parts:
C11, C12, C14: 100n; C_0805_2012Metric_Pad1.18x1.45mm_HandSolder
C13: 22u; C_0805_2012Metric_Pad1.18x1.45mm_HandSolder
D1: LED_Dual_AAK; SOT-23
IC2: ESP32-WROVER-IE; ESP32WROVERIE; Manufacturer_Part_Number ESP32-WROVER-IE; Mouser 356-ESP32WVIE23264UC
J6: Conn_01x04_Pin; PinHeader_1x04_P2.54mm_Vertical
J7: Conn_ARM_JTAG_SWD_10; PinHeader_2x05_P1.27mm_Vertical_SMD
JP1: Jumper_2_Open; PinHeader_1x02_P2.54mm_Vertical
R9: 10k; R_0805_2012Metric_Pad1.20x1.40mm_HandSolder
R10: 68; R_0805_2012Metric_Pad1.20x1.40mm_HandSolder
R11: 56; R_0805_2012Metric_Pad1.20x1.40mm_HandSolder
SW1: SW_Push; SW_PUSH_6mm_H7.3mm

Connections:
+3V3: C12.1, C13.1, C14.1, IC2.2 (3V3), J6.1, J7.1 (VTref), R9.2; also elsewhere on the board
/LASER1_CNTR: IC2.11 (IO26); also elsewhere on the board
/LASER1_MD_MEAS: IC2.4 (SENSOR_VP); also elsewhere on the board
/LASER1_TEMP_uC: IC2.7 (IO35); also elsewhere on the board
/LASER2_CNTR: IC2.10 (IO25); also elsewhere on the board
/LASER2_MD_MEAS: IC2.5 (SENSOR_VN); also elsewhere on the board
/LASER2_TEMP_uC: IC2.6 (IO34); also elsewhere on the board
/Mikrocontroller/BOOT: IC2.25 (IO0), JP1.2 (B)
/Mikrocontroller/ESP32_EN: C11.2, IC2.3 (EN), J7.10 (~RESET), R9.1, SW1.2
/Mikrocontroller/ESP32_JTAG_TCK: IC2.16 (IO13), J7.4 (SWDCLK/TCK)
/Mikrocontroller/ESP32_JTAG_TDI: IC2.14 (IO12), J7.8 (NC/TDI)
/Mikrocontroller/ESP32_JTAG_TDO: IC2.23 (IO15), J7.6 (SWO/TDO)
/Mikrocontroller/ESP32_JTAG_TMS: IC2.13 (IO14), J7.2 (SWDIO/TMS)
/Mikrocontroller/LED_GREEN: IC2.29 (IO5), R11.2
/Mikrocontroller/LED_RED: IC2.30 (IO18), R10.2
/Mikrocontroller/SERIAL_RX: IC2.34 (RXD0), J6.2
/Mikrocontroller/SERIAL_TX: IC2.35 (TXD0), J6.3
/PELT1_FWD: IC2.33 (IO21); also elsewhere on the board
/PELT1_REV: IC2.31 (IO19); also elsewhere on the board
/PELT2_FWD: IC2.37 (IO23); also elsewhere on the board
/PELT2_REV: IC2.36 (IO22); also elsewhere on the board
GND: C11.1, C12.2, C13.2, C14.2, D1.3 (K), IC2.1 (GND_1), IC2.15 (GND_2), IC2.38 (GND_3), IC2.39 (GND_4), IC2.40 (GND_5), IC2.41 (GND_6), IC2.42 (GND_7), IC2.43 (GND_8), IC2.44 (GND_9), IC2.45 (GND_10), IC2.46 (GND_11), IC2.47 (GND_12), J6.4, J7.3 (GND), J7.5 (GND), J7.9 (GNDDetect), JP1.1 (A), SW1.1; also elsewhere on the board
unnamed: D1.1 (A1), R10.1
unnamed: D1.2 (A2), R11.1

Notes on the sheet:
Signalling LED
JTAG 10P programming header
ESP32 RS232-TTL Programming/DEBUG
ESP32

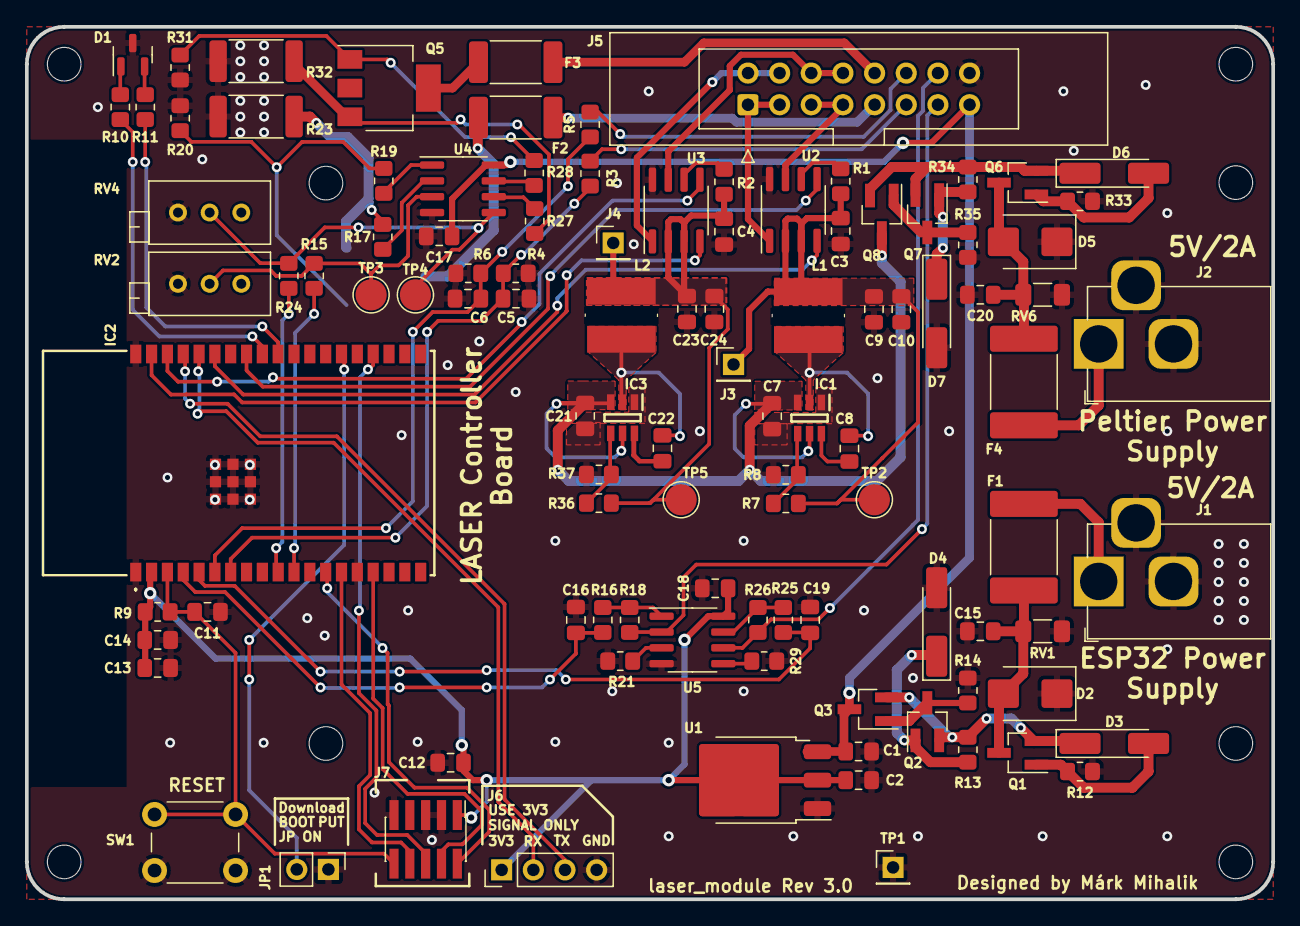
[picture p10: board laser_module_kicad_prj.kicad_pcb from above]

Board: 2 copper layers, 100.0 x 70.0 mm, 106 parts (1 on the bottom side), 74 nets.
