Residuum22/EDFAController/EDFABoards/Hardware/voa_controller_kicad_prj/voa_controller_kicad_prj.kicad_pcb

## KiCad design EDFABoards/Hardware/voa_controller_kicad_prj/voa_controller_kicad_prj.kicad_pcb (2024-10-13)

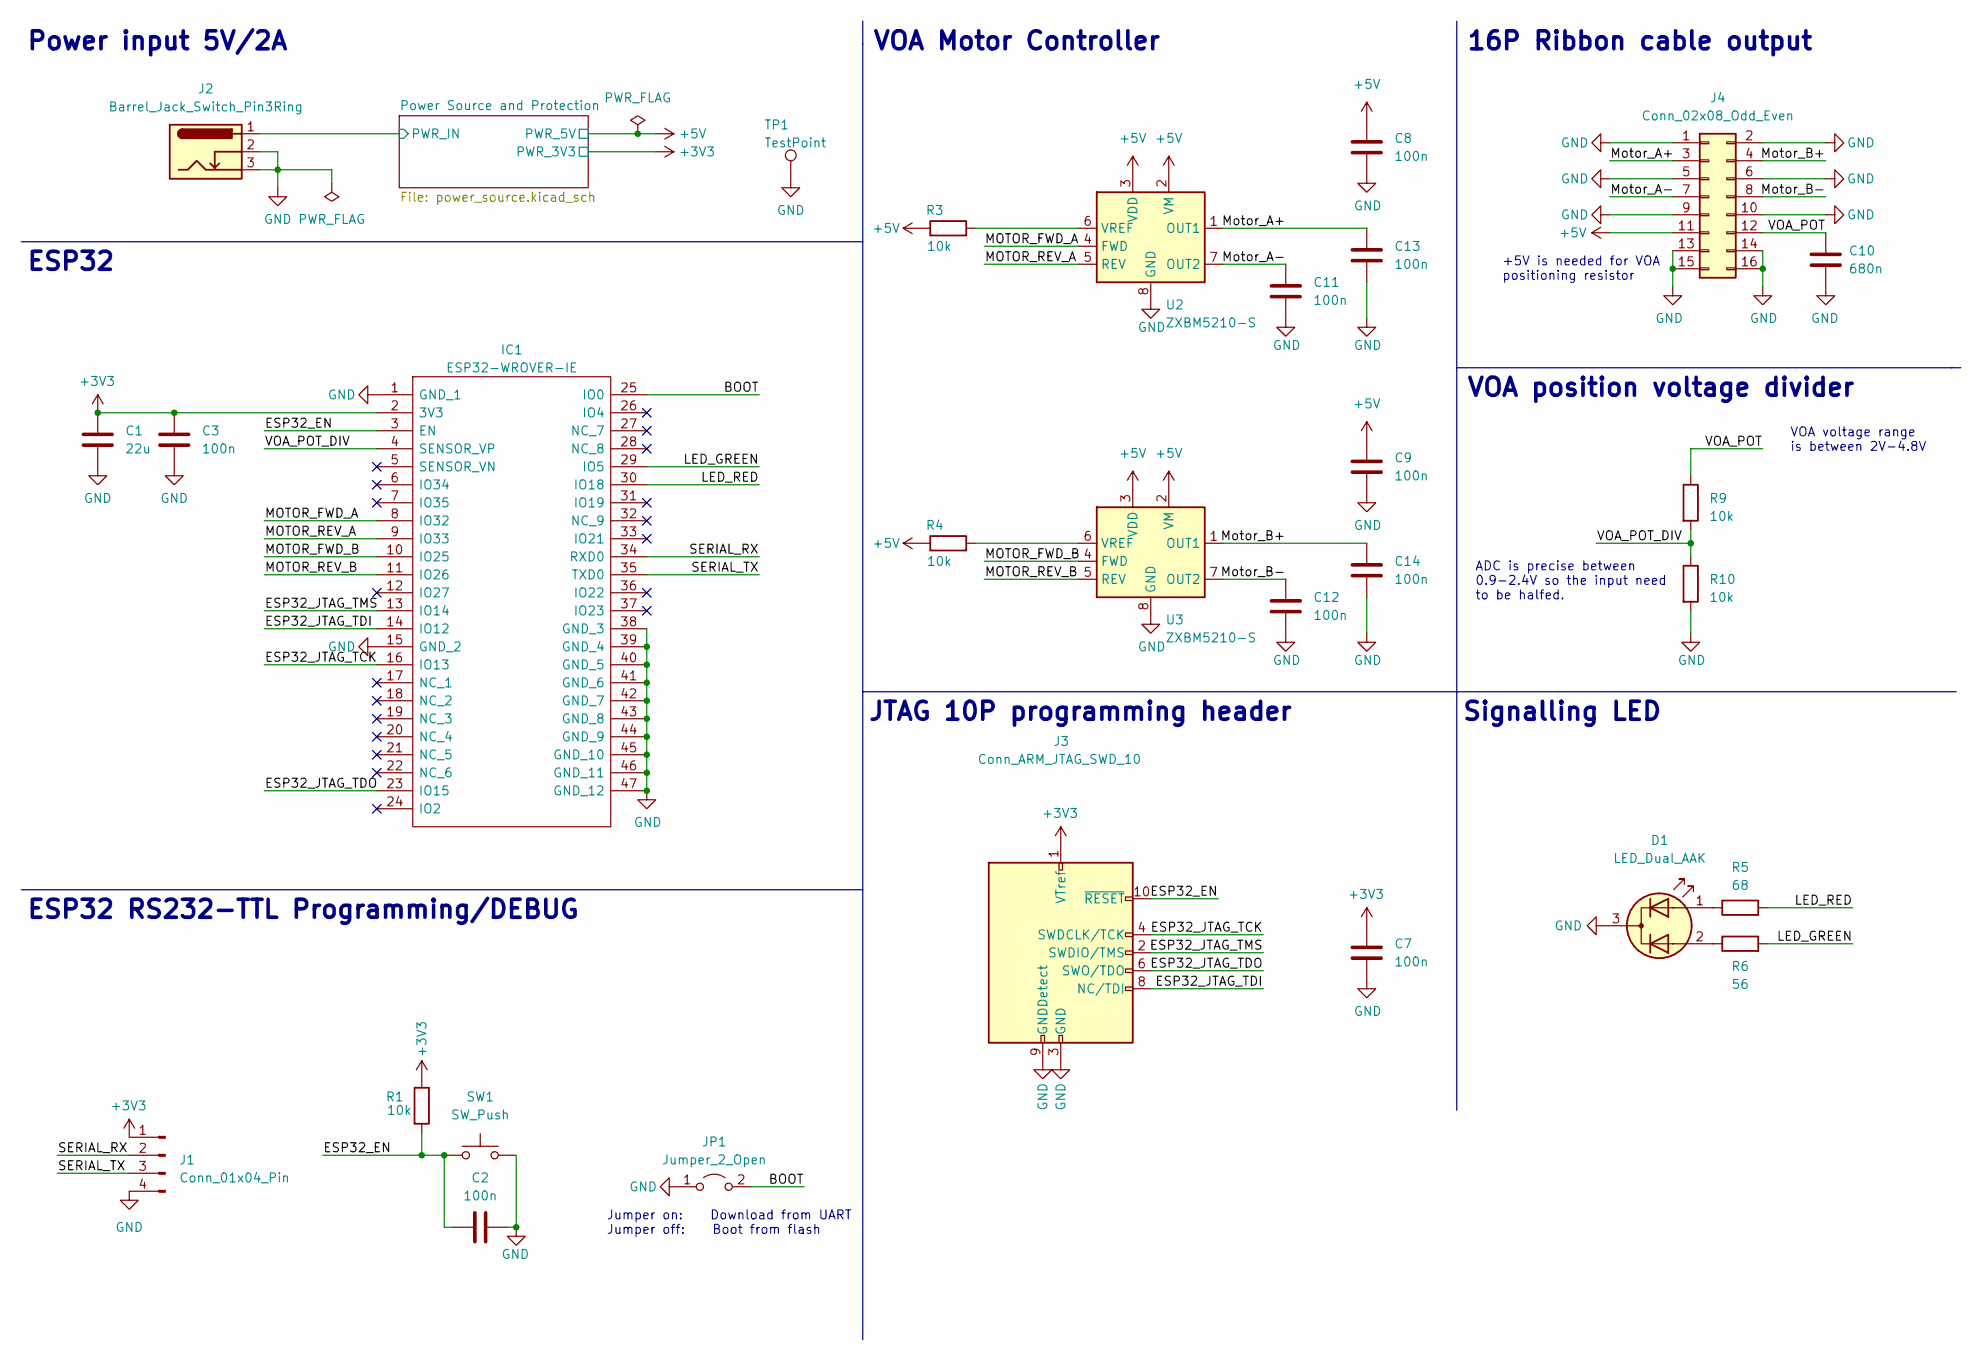
[picture p11: schematic voa_controller_kicad_prj.kicad_sch, Voltage Controlled Amplifier (VOA) controller board]

Parts:
C1: 22u; C_0805_2012Metric_Pad1.18x1.45mm_HandSolder
C2, C3, C7, C8, C9, C11, C12, C13, C14: 100n; C_0805_2012Metric_Pad1.18x1.45mm_HandSolder
C10: 680n; C_0805_2012Metric_Pad1.18x1.45mm_HandSolder
D1: LED_Dual_AAK; SOT-23
IC1: ESP32-WROVER-IE; ESP32WROVERIE; Manufacturer_Part_Number ESP32-WROVER-IE; Mouser 356-ESP32WVIE23264UC
J1: Conn_01x04_Pin; PinHeader_1x04_P2.54mm_Vertical
J2: Barrel_Jack_Switch_Pin3Ring; BarrelJack_Horizontal
J3: Conn_ARM_JTAG_SWD_10; PinHeader_2x05_P1.27mm_Vertical_SMD
J4: Conn_02x08_Odd_Even; IDC-Header_2x08_P2.54mm_Latch_Vertical
JP1: Jumper_2_Open; PinHeader_1x02_P2.54mm_Vertical
R1, R3, R4, R9, R10: 10k; R_0805_2012Metric_Pad1.20x1.40mm_HandSolder
R5: 68; R_0805_2012Metric_Pad1.20x1.40mm_HandSolder
R6: 56; R_0805_2012Metric_Pad1.20x1.40mm_HandSolder
SW1: SW_Push; SW_PUSH_6mm_H7.3mm
TP1: TestPoint; PinHeader_1x01_P2.54mm_Vertical
U2, U3: ZXBM5210-S; SOIC-8_3.9x4.9mm_P1.27mm; Mouser 621-ZXBM5210-S-13

Connections:
+3V3: C1.1, C3.1, C7.1, IC1.2 (3V3), J1.1, J3.1 (VTref), R1.2; also elsewhere on the board
+5V: C8.1, C9.1, J4.11, R3.1, R4.1, U2.2 (VM), U2.3 (VDD), U3.2 (VM), U3.3 (VDD); also elsewhere on the board
/BOOT: IC1.25 (IO0), JP1.2 (B)
/ESP32_EN: C2.2, IC1.3 (EN), J3.10 (~RESET), R1.1, SW1.2
/ESP32_JTAG_TCK: IC1.16 (IO13), J3.4 (SWDCLK/TCK)
/ESP32_JTAG_TDI: IC1.14 (IO12), J3.8 (NC/TDI)
/ESP32_JTAG_TDO: IC1.23 (IO15), J3.6 (SWO/TDO)
/ESP32_JTAG_TMS: IC1.13 (IO14), J3.2 (SWDIO/TMS)
/LED_GREEN: IC1.29 (IO5), R6.2
/LED_RED: IC1.30 (IO18), R5.2
/MOTOR_FWD_A: IC1.8 (IO32), U2.4 (FWD)
/MOTOR_FWD_B: IC1.10 (IO25), U3.4 (FWD)
/MOTOR_REV_A: IC1.9 (IO33), U2.5 (REV)
/MOTOR_REV_B: IC1.11 (IO26), U3.5 (REV)
/Motor_A+: C13.1, J4.3, U2.1 (OUT1)
/Motor_A-: C11.1, J4.7, U2.7 (OUT2)
/Motor_B+: C14.1, J4.4, U3.1 (OUT1)
/Motor_B-: C12.1, J4.8, U3.7 (OUT2)
/Power Source and Protection/PWR_IN: J2.1; also elsewhere on the board
/SERIAL_RX: IC1.34 (RXD0), J1.2
/SERIAL_TX: IC1.35 (TXD0), J1.3
/VOA_POT: C10.1, J4.12, R9.1
/VOA_POT_DIV: IC1.4 (SENSOR_VP), R9.2, R10.1
GND: C1.2, C2.1, C3.2, C7.2, C8.2, C9.2, C10.2, C11.2, C12.2, C13.2, C14.2, D1.3 (K), IC1.1 (GND_1), IC1.15 (GND_2), IC1.38 (GND_3), IC1.39 (GND_4), IC1.40 (GND_5), IC1.41 (GND_6), IC1.42 (GND_7), IC1.43 (GND_8), IC1.44 (GND_9), IC1.45 (GND_10), IC1.46 (GND_11), IC1.47 (GND_12), J1.4, J2.2, J2.3, J3.3 (GND), J3.5 (GND), J3.9 (GNDDetect), J4.1, J4.2, J4.5, J4.6, J4.9, J4.10, J4.13, J4.14, J4.15, J4.16, JP1.1 (A), R10.2, SW1.1, TP1.1, U2.8 (GND), U3.8 (GND); also elsewhere on the board
unnamed: D1.1 (A1), R5.1
unnamed: D1.2 (A2), R6.1
unnamed: R3.2, U2.6 (VREF)
unnamed: R4.2, U3.6 (VREF)

Notes on the sheet:
JTAG 10P programming header
ESP32
16P Ribbon cable output
VOA position voltage divider
VOA Motor Controller
ESP32 RS232-TTL Programming/DEBUG
ADC is precise between 0.9-2.4V so the input need to be halfed.
VOA voltage range is between 2V-4.8V
Signalling LED
Jumper on: Download from UART Jumper off: Boot from flash
Power input 5V/2A
+5V is needed for VOA positioning resistor

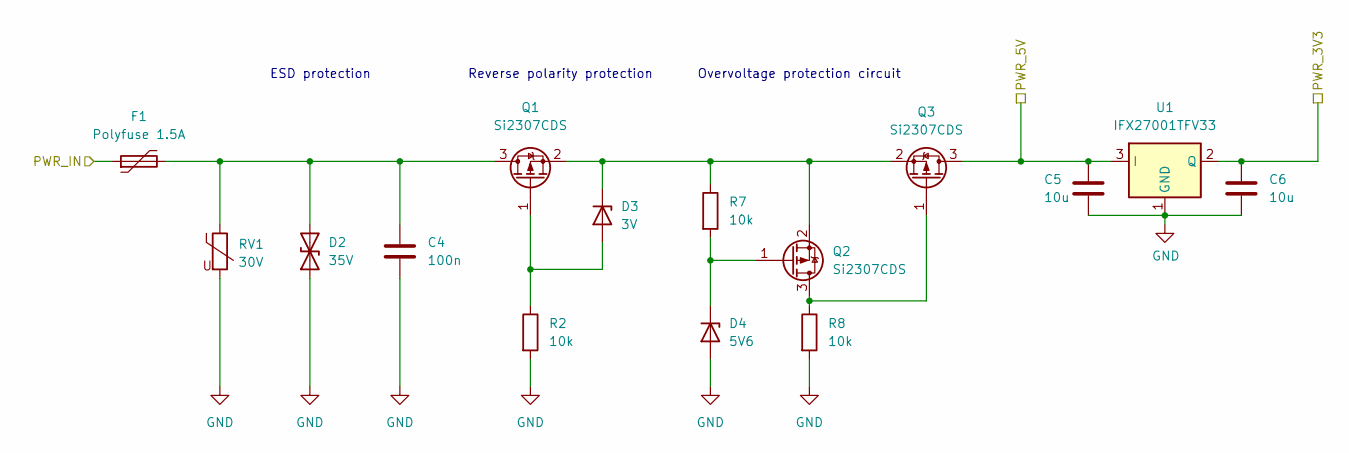
[picture p12: schematic power_source.kicad_sch, Voltage Controlled Amplifier (VOA) controller board]

Parts:
C4: 100n; C_0805_2012Metric_Pad1.18x1.45mm_HandSolder
C5, C6: 10u; C_0805_2012Metric_Pad1.18x1.45mm_HandSolder
D2: 35V; D_SMB
D3: 3V; D_MiniMELF_Handsoldering
D4: 5V6; D_MiniMELF_Handsoldering
F1: Polyfuse 1.5A; Fuse_1812_4532Metric
Q1, Q2, Q3: Si2307CDS; SOT-23_Handsoldering
R2, R7, R8: 10k; R_0805_2012Metric_Pad1.20x1.40mm_HandSolder
RV1: 30V; R_1206_3216Metric
U1: IFX27001TFV33; TO-252-3_TabPin2

Connections:
+3V3: C6.1, U1.2 (Q); also elsewhere on the board
+5V: C5.1, Q3.3 (D), U1.3 (I); also elsewhere on the board
/Power Source and Protection/PWR_IN: F1.1; also elsewhere on the board
GND: C4.2, C5.2, C6.2, D2.1 (A1), D4.2 (A), R2.2, R8.2, RV1.2, U1.1 (GND); also elsewhere on the board
unnamed: C4.1, D2.2 (A2), F1.2, Q1.3 (D), RV1.1
unnamed: D3.2 (A), Q1.1 (G), R2.1
unnamed: D3.1 (K), Q1.2 (S), Q2.2 (S), Q3.2 (S), R7.1
unnamed: D4.1 (K), Q2.1 (G), R7.2
unnamed: Q2.3 (D), Q3.1 (G), R8.1

Notes on the sheet:
Overvoltage protection circuit
ESD protection
Reverse polarity protection

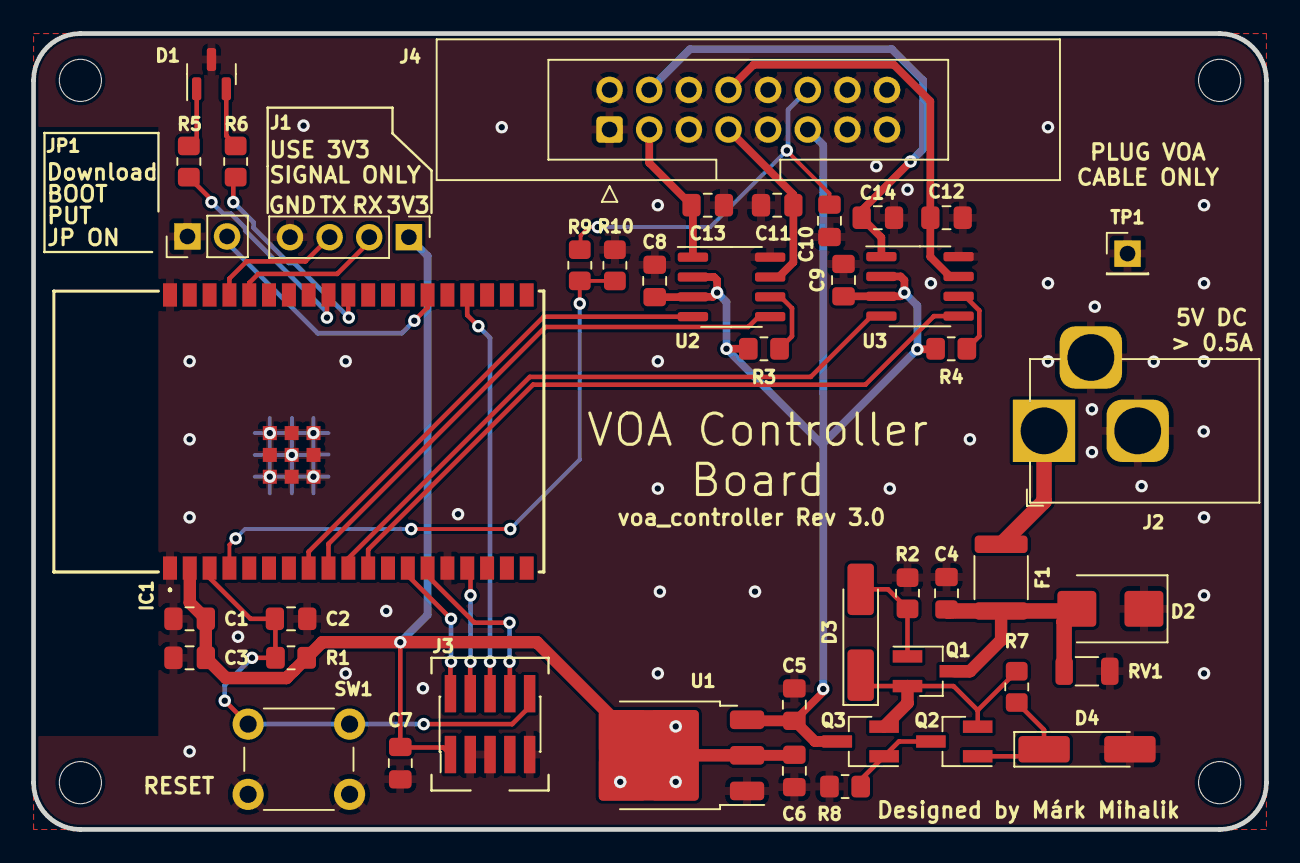
[picture p13: board voa_controller_kicad_prj.kicad_pcb from above]

Board: 2 copper layers, 79.0 x 51.0 mm, 48 parts (0 on the bottom side), 33 nets.

Other parts of the board:
REF01, REF02, REF03, REF04: MountingHole_2.7mm_M2.5
