Residuum22/EDFAController/EDFABoards/Firmware/voa_board_firmware/main/include/common_gpio.h

#pragma once
#include "hal/gpio_types.h"

#define VOA_FWD_A_PIN           GPIO_NUM_32
#define VOA_FWD_B_PIN           GPIO_NUM_25

#define VOA_REV_A_PIN           GPIO_NUM_33
#define VOA_REV_B_PIN           GPIO_NUM_26

#define VOA_POT_PIN             GPIO_NUM_4

#define INDICATOR_RED_GPIO      GPIO_NUM_18
#define INDICATOR_GREEN_GPIO    GPIO_NUM_5
