Residuum22/EDFAController/(commit log)

2022-04-24 VOA controller schematics added
    [laser_module_kicad_prj.kicad_pcb, laser_module_kicad_prj.kicad_sch, voa_controller_kicad_prj.kicad_pcb, voa_controller_kicad_prj.kicad_sch]
2022-05-04 VOA pcb + better schematics
    [voa_controller_kicad_prj.kicad_pcb, voa_controller_kicad_prj.kicad_sch]
2022-05-05 Add VOA board teardrops and bigger power track vias
    [voa_controller_kicad_prj.kicad_pcb]
2022-05-05 Better power trace
    [voa_controller_kicad_prj.kicad_pcb]
2022-05-05 New develop branch with voa and laser controller save
    [cooling_circuit.kicad_sch, laser_module_kicad_prj.kicad_pcb, laser_module_kicad_prj.kicad_sch, lazer_controll.kicad_sch, microcontroller.kicad_sch, power_supply.kicad_sch]
2022-05-05 VOA controller waiting for revision
    [voa_controller_kicad_prj.kicad_pcb, voa_controller_kicad_prj.kicad_sch]
2022-05-05 Laser module schematic ready to revision
    [laser_module_kicad_prj.kicad_pcb, laser_module_kicad_prj.kicad_sch, lazer_controll.kicad_sch, microcontroller.kicad_sch, power_supply.kicad_sch]
2022-05-06 Laser controller Ready to rev
    [laser_module_kicad_prj.kicad_pcb, laser_module_kicad_prj.kicad_sch, lazer_controll.kicad_sch, microcontroller.kicad_sch]
2022-05-06 VOA PCB ribbon con. changed and laser PCB teardrops added
    [laser_module_kicad_prj.kicad_pcb, voa_controller_kicad_prj.kicad_pcb, voa_controller_kicad_prj.kicad_sch]
2022-05-06 Something changed
    [laser_module_kicad_prj.kicad_pcb, laser_module_kicad_prj.kicad_sch, lazer_controll.kicad_sch, voa_controller_kicad_prj.kicad_pcb]
2022-09-12 Add necessary documentation and update cable board NC and GND pins according to the documentation
    [WaveStar_Optical_Design_062499.xls, cable_board_kicad_prj.kicad_sch]
2022-09-12 Update cable board with VOA connections and add some text to the VOA board
    [cable_board_kicad_prj.kicad_sch, voa_controller_kicad_prj.kicad_sch]
2022-09-13 Add copper fill keepout area under the esp32 for easier soldering
    [voa_controller_kicad_prj.kicad_pcb]
2022-09-14 Laser module clean up
    [laser_module_kicad_prj.kicad_sch, power_supply.kicad_sch]
2022-09-14 Cable board sign all EDFA connector pin & PDF delete markers & cleanup
    [cable_board_kicad_prj.kicad_sch, power_supply.kicad_sch]
2022-10-04 Add LTSpice simulation, esp32 datasheet to the project and add kicad script for bom generation and add protection for voa module with finished schematics
    [cable_board_kicad_prj.kicad_pcb, cable_board_kicad_prj.kicad_sch, laser_module_kicad_prj.kicad_pcb, laser_module_kicad_prj.kicad_sch, lazer_controll.kicad_sch, microcontroller.kicad_sch, order1.xlsx, order2.xlsx]
2022-10-07 VOA controller ready to review
    [voa_controller_kicad_prj.kicad_pcb, voa_controller_kicad_prj.kicad_sch]
2022-10-08 Add simulations for laser module
2022-10-08 Fix laser controll circuit and add lowpass to the end of monitor diode amplifier.
    [5V_3V3_converter.kicad_sch, 5V_3V3_converter_2.kicad_sch, laser_controll.kicad_sch, laser_module_kicad_prj.kicad_sch, microcontroller.kicad_sch, power_supply.kicad_sch]
2022-10-09 Ready to review of laser_module
    [5V_3V3_converter.kicad_sch, 5V_3V3_converter_2.kicad_sch, laser_controll.kicad_sch, laser_module_kicad_prj.kicad_pcb, laser_module_kicad_prj.kicad_sch, microcontroller.kicad_sch, peltierpowersupply.kicad_sch]
2022-10-09 Cable board ready to review
    [cable_board_kicad_prj.kicad_pcb, cable_board_kicad_prj.kicad_sch]
2022-10-09 Some fix changes
    [laser_module_kicad_prj.kicad_pcb, voa_controller_kicad_prj.kicad_pcb]
2022-10-17 Update hardware
    [5V_3V3_converter.kicad_sch, cable_board_kicad_prj.kicad_pcb, cable_board_kicad_prj.kicad_sch, laser_controll.kicad_sch, laser_module_kicad_prj.kicad_pcb, power_supply.kicad_sch, voa_controller_kicad_prj.kicad_pcb, voa_controller_kicad_prj.kicad_sch]
2023-03-10 Add laser events script (currently just for laser1)
2023-03-11 Add websocket processing for laser_module and voa_module, add websocket test, change enable disable api for sorten url
    TODO: Write test to run test in the same time, and wirte javascript for automatically get data from backend and show in the frontend
2023-03-12 Add laser module generator with templates, fix backend to stay active if no module is connected, modify laser events javascript better naming
2023-03-12 WIP: Add laser module js (currently not working sync commit)
2023-03-14 Add laser module websocket processing into the frontend
2023-04-19 Simulation and sch modification
    [laser_controll.kicad_sch, laser_module_kicad_prj.kicad_sch]
2023-04-19 Add simulation and fix laser controll circuit
    [laser_controll.kicad_sch, laser_module_kicad_prj.kicad_pcb, laser_module_kicad_prj.kicad_sch]
2023-04-19 Move project folder up in hardware.
    [5V_3V3_converter.kicad_sch, 5V_3V3_converter_2.kicad_sch, cable_board_kicad_prj.kicad_pcb, cable_board_kicad_prj.kicad_sch, cooling_circuit.kicad_sch, laser_controll.kicad_sch, laser_module_kicad_prj.kicad_pcb, laser_module_kicad_prj.kicad_sch]
2023-04-19 Add boms to project
    [5V_3V3_converter.kicad_sch, Basket_Oct25_0738AM.xls, laser_controll.kicad_sch, laser_module_kicad_prj.csv, laser_module_kicad_prj.kicad_pcb, laser_module_kicad_prj.kicad_sch, lomex_57250_1666699567.csv, voa_controller_kicad_prj.csv]
2023-04-19 Change DC connector pad from oval to circle
    Add 3v3 connector for external power supply
    [5V_3V3_converter.kicad_sch, laser_module_kicad_prj.kicad_pcb, laser_module_kicad_prj.kicad_sch, voa_controller_kicad_prj.kicad_pcb]
2023-04-19 Add voa hw test in arduino framework
2023-04-19 Refactor project structure
    [Basket_Oct25_0738AM.xls, WaveStar_Optical_Design_062499.xls, laser_module_kicad_prj.csv, lomex_57250_1666699567.csv, order1.xlsx, order2.xlsx, voa_controller_kicad_prj.csv]
2023-04-19 Add simulated laser modules
2023-04-19 (FIX) Add voltage divider to 5V potentiometer from voa
    [power_source.kicad_sch, voa_controller_kicad_prj.kicad_pcb, voa_controller_kicad_prj.kicad_sch]
2023-04-19 Hardware tmp laser controller design
    [5V_3V3_converter.kicad_sch, laser_controll.kicad_sch, laser_module_kicad_prj.kicad_sch, microcontroller.kicad_sch, power_supply.kicad_sch]
2023-04-19 Modify laser board schematics according to the prototype issues.
    Add the monitor diode part to the PCB
    Update revision and finish PCBs
    [5V_3V3_converter.kicad_sch, laser_controll.kicad_sch, laser_module_kicad_prj.kicad_pcb, laser_module_kicad_prj.kicad_sch, microcontroller.kicad_sch, power_source.kicad_sch, power_supply.kicad_sch, voa_controller_kicad_prj.kicad_pcb]
2023-04-19 Modify main.c and init zxbm5210 drivers
2023-04-19 Change laser controller circuit add resistor to feedback pin of the op amp
    Add SOT-223 new fet to the board.
    [5V_3V3_converter.kicad_sch, laser_controll.kicad_sch, laser_module_kicad_prj.kicad_pcb, laser_module_kicad_prj.kicad_sch, microcontroller.kicad_sch, power_supply.kicad_sch]
2023-04-19 Remove zxbm5210 driver and readme files. Add lwjson repo to the project for future use.
2023-04-19 VOA firmware with MQTT and WIFI and MCPWM
    [custom_board.cfg, partitions.csv]
2023-04-20 VOA hw: Rev 3.0 & Change ADC instance.
    Hardware change, because the ADC2 used by WiFi.
    [power_source.kicad_sch, voa_controller_kicad_prj.kicad_pcb, voa_controller_kicad_prj.kicad_sch]
2023-05-21 Fix desired temperature according to the new system design and send it through mqtt
2023-06-10 Refactor main.c
    Move lots of function into the correct place.
    [led_indicator_voa.c, voa_control.c, voa_control.h]
2023-06-27 Change reserve voltage protection simulation to better demonstration.
2023-06-27 VOA hw: Change version number and prepare for finilazing.
    [power_source.kicad_sch, voa_controller_kicad_prj.kicad_pcb, voa_controller_kicad_prj.kicad_sch]
2023-06-27 Laser hw: Update laser revision number, add potentiometer to measurement diodes, connect all analog siganal to ADC1
    [5V_3V3_converter.kicad_sch, laser_controll.kicad_sch, laser_module_kicad_prj.kicad_pcb, laser_module_kicad_prj.kicad_sch, microcontroller.kicad_sch, power_supply.kicad_sch]
2023-06-27 Cable brd: Move to kicad 7.0, elimanate wrong connection with voa.
    [cable_board_kicad_prj.kicad_pcb, cable_board_kicad_prj.kicad_sch]
2023-07-27 [VOA Software] Add end-position mapping and emergency stop of voa is stucked.
    [voa_control.c, voa_control.h]
2023-08-20 Add json parsing and laser module reports working again.
2023-09-19 [VOA Software] Fix code and refactor
    [voa_control.c]
2023-10-06 [VOA Software] Fix indicator connecting and add error basic error handling.
    [led_indicator_voa.c, voa_control.c]
2023-10-06 [Laser Software] Initialize laser software project (copy-voa project)
    [custom_board.cfg, partitions.csv]
2023-10-06 [Laser Software] Port to 5.1.1 and develop the basics of the laser application
2023-10-08 [Laser Software] Add peltier bang-bang controller, code butify and update README
    [custom_board.cfg]
2023-10-08 [Laser Software] Add exponential and linear interpolated temperature measuring of the Peltier
2023-10-10 [Laser Software] Add laser current control and change mqtt message to wait for laser_current not for monitor diode current
2023-10-12 Change monitor diode to laser diode
2023-10-16 [VOA Software] Fix stepper motor control
    [voa_control.c]
2023-10-21 [Laser Software]: WIP enable button is not working
    [laser_module_adc.c, peltier_control.c]
2023-10-22 [VOA Software]: Ready for the final testing of the VOA software.
    [custom_board.cfg]
2023-10-29 [Laser Software]: Add PID controller for Peltier, refactor code, change uint8_t laser enable
2023-10-30 [Laser Software]: Write MD to serial
2023-11-03 [Cable Hardware]: Fix short in the panel
    [cable_board_kicad_prj.kicad_pcb, cable_board_kicad_prj.kicad_sch]
2023-11-03 [Laser Hardware]: Fix temp reading issue due to hardware
    [5V_3V3_converter.kicad_sch, laser_controll.kicad_sch, laser_module_kicad_prj.kicad_pcb, laser_module_kicad_prj.kicad_sch, microcontroller.kicad_sch, power_supply.kicad_sch]
2023-12-10 [Laser Software] Adjust code in the laboratory
2023-12-10 [Laser Software] Add laser pid controller
2023-12-10 [Laser Firmware] Calibrate peltier and laser control pid
2023-12-10 [Laser Firmware] Adjust PID values by the peltier and the laser current
2023-12-10 [Laser Firmware] Add current conversion by the laser current
2023-12-10 [Laser Firmware] Enable debug level logging
2023-12-10 [Laser Firmware] Add enable for the laser current adjustment
2023-12-11 [Laser Firmware] Add enable for lasers, implement report initial untested logic, remove bang-bang controller from peltier
2024-01-06 [Laser Hardware]: Fix PCB with the new laser current source design.
    [laser_controll.kicad_sch, laser_module_kicad_prj.kicad_pcb]
2024-01-06 [VOA Hardware]: Create warning excludes which is not relevant
    [voa_controller_kicad_prj.kicad_pcb]
2024-01-06 [Cable Hardware] Change monitor diodes connection.
    [cable_board_kicad_prj.kicad_pcb, cable_board_kicad_prj.kicad_sch]
2024-01-28 Revert "[Cable Hardware] Change monitor diodes connection."
    This reverts commit 7c23bd38936932b363231632e559990db4feac3f.
    [cable_board_kicad_prj.kicad_pcb, cable_board_kicad_prj.kicad_sch]
2024-01-28 [Cable Hardware] Add solder connector for the monitor diode cathode.
    [cable_board_kicad_prj.kicad_pcb, cable_board_kicad_prj.kicad_sch]
2024-02-03 [TestSoftware]: EDFA Laser board cJSON test
2024-06-02 [Firmware]: Remove info logging from PID controller
2024-06-02 [Firmware]: Fix LaserModule cJSON stack overflow and increase time between report generations
2024-06-02 Show current settings after reload of the page
2024-10-08 Port Website to Raspberry Pi
